Shank-Mods/LumaDoub/hardware/LumaDoubDevBoard/LumaDoubDevBoard.kicad_pcb

## KiCad design hardware/LumaDoubDevBoard/LumaDoubDevBoard.kicad_pcb (2026-09-02)

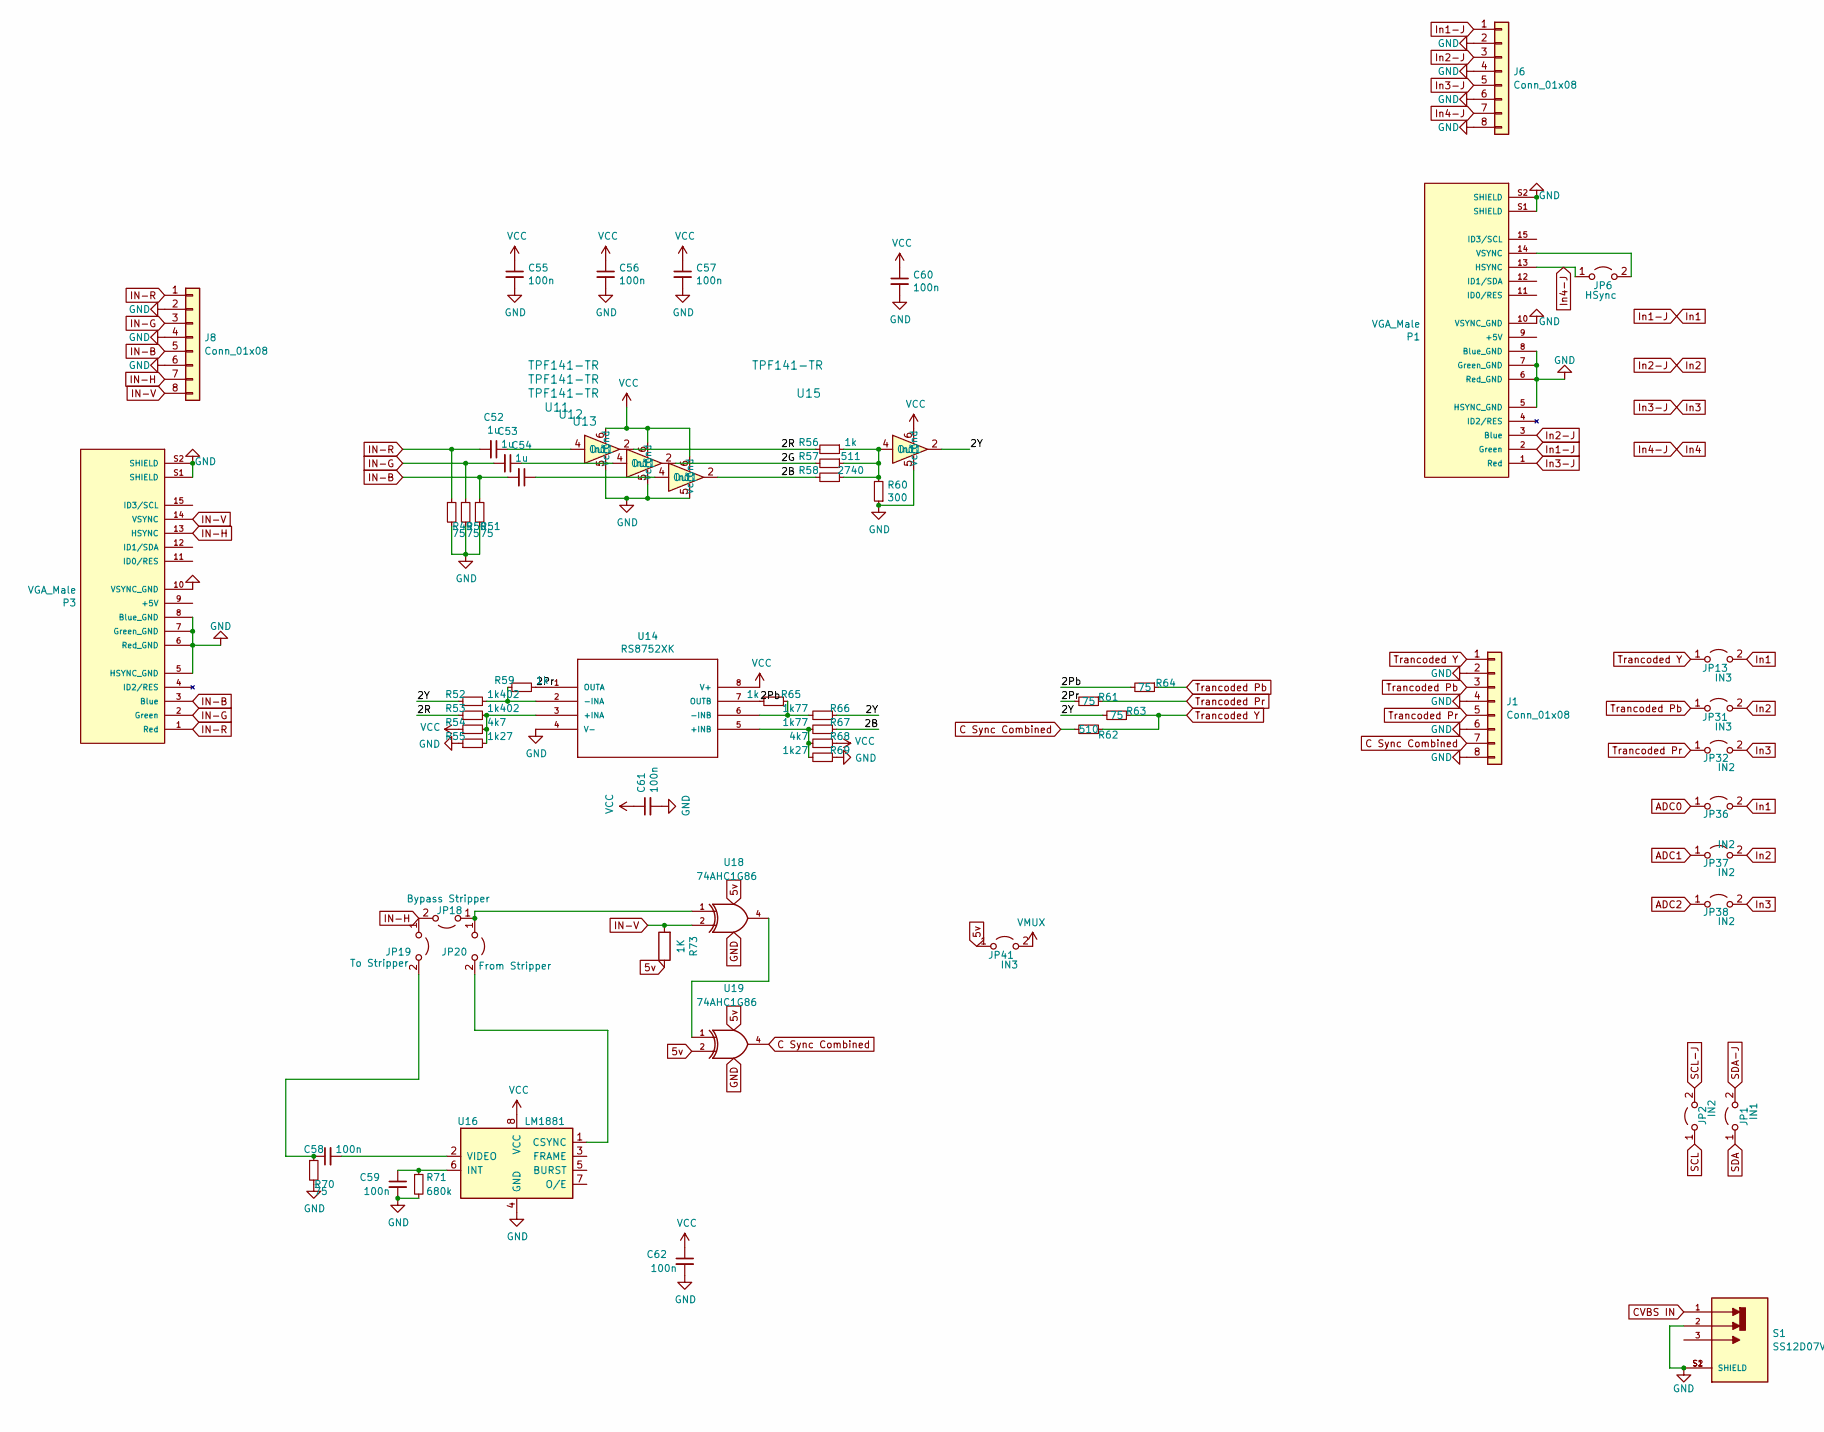
[picture p1: schematic LumaDoubDevBoard.kicad_sch, part in row 1, column 1]

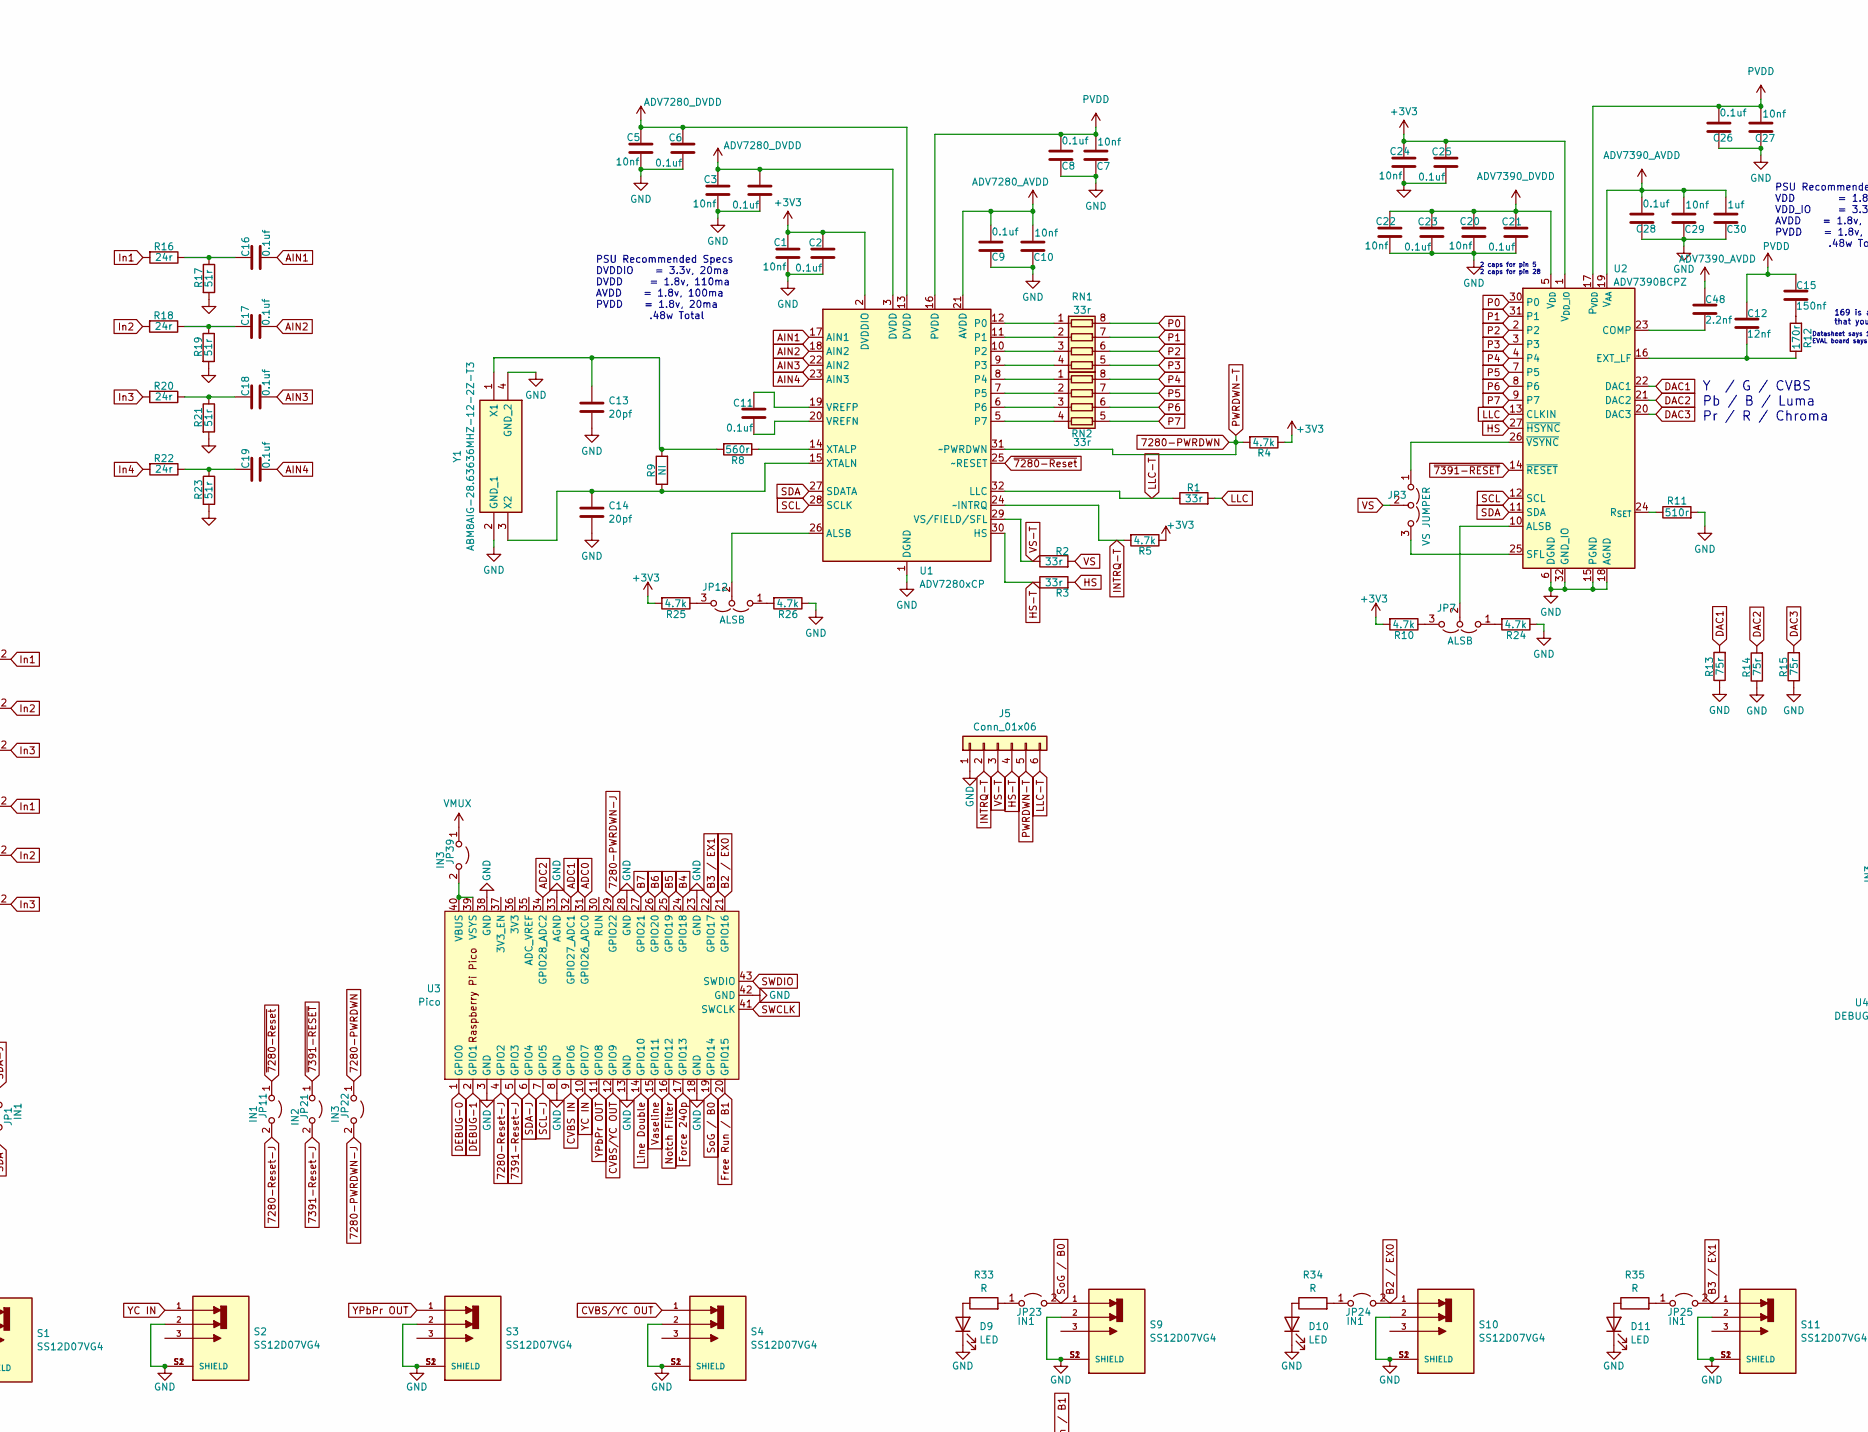
[picture p2: schematic LumaDoubDevBoard.kicad_sch, part in row 1, column 2]

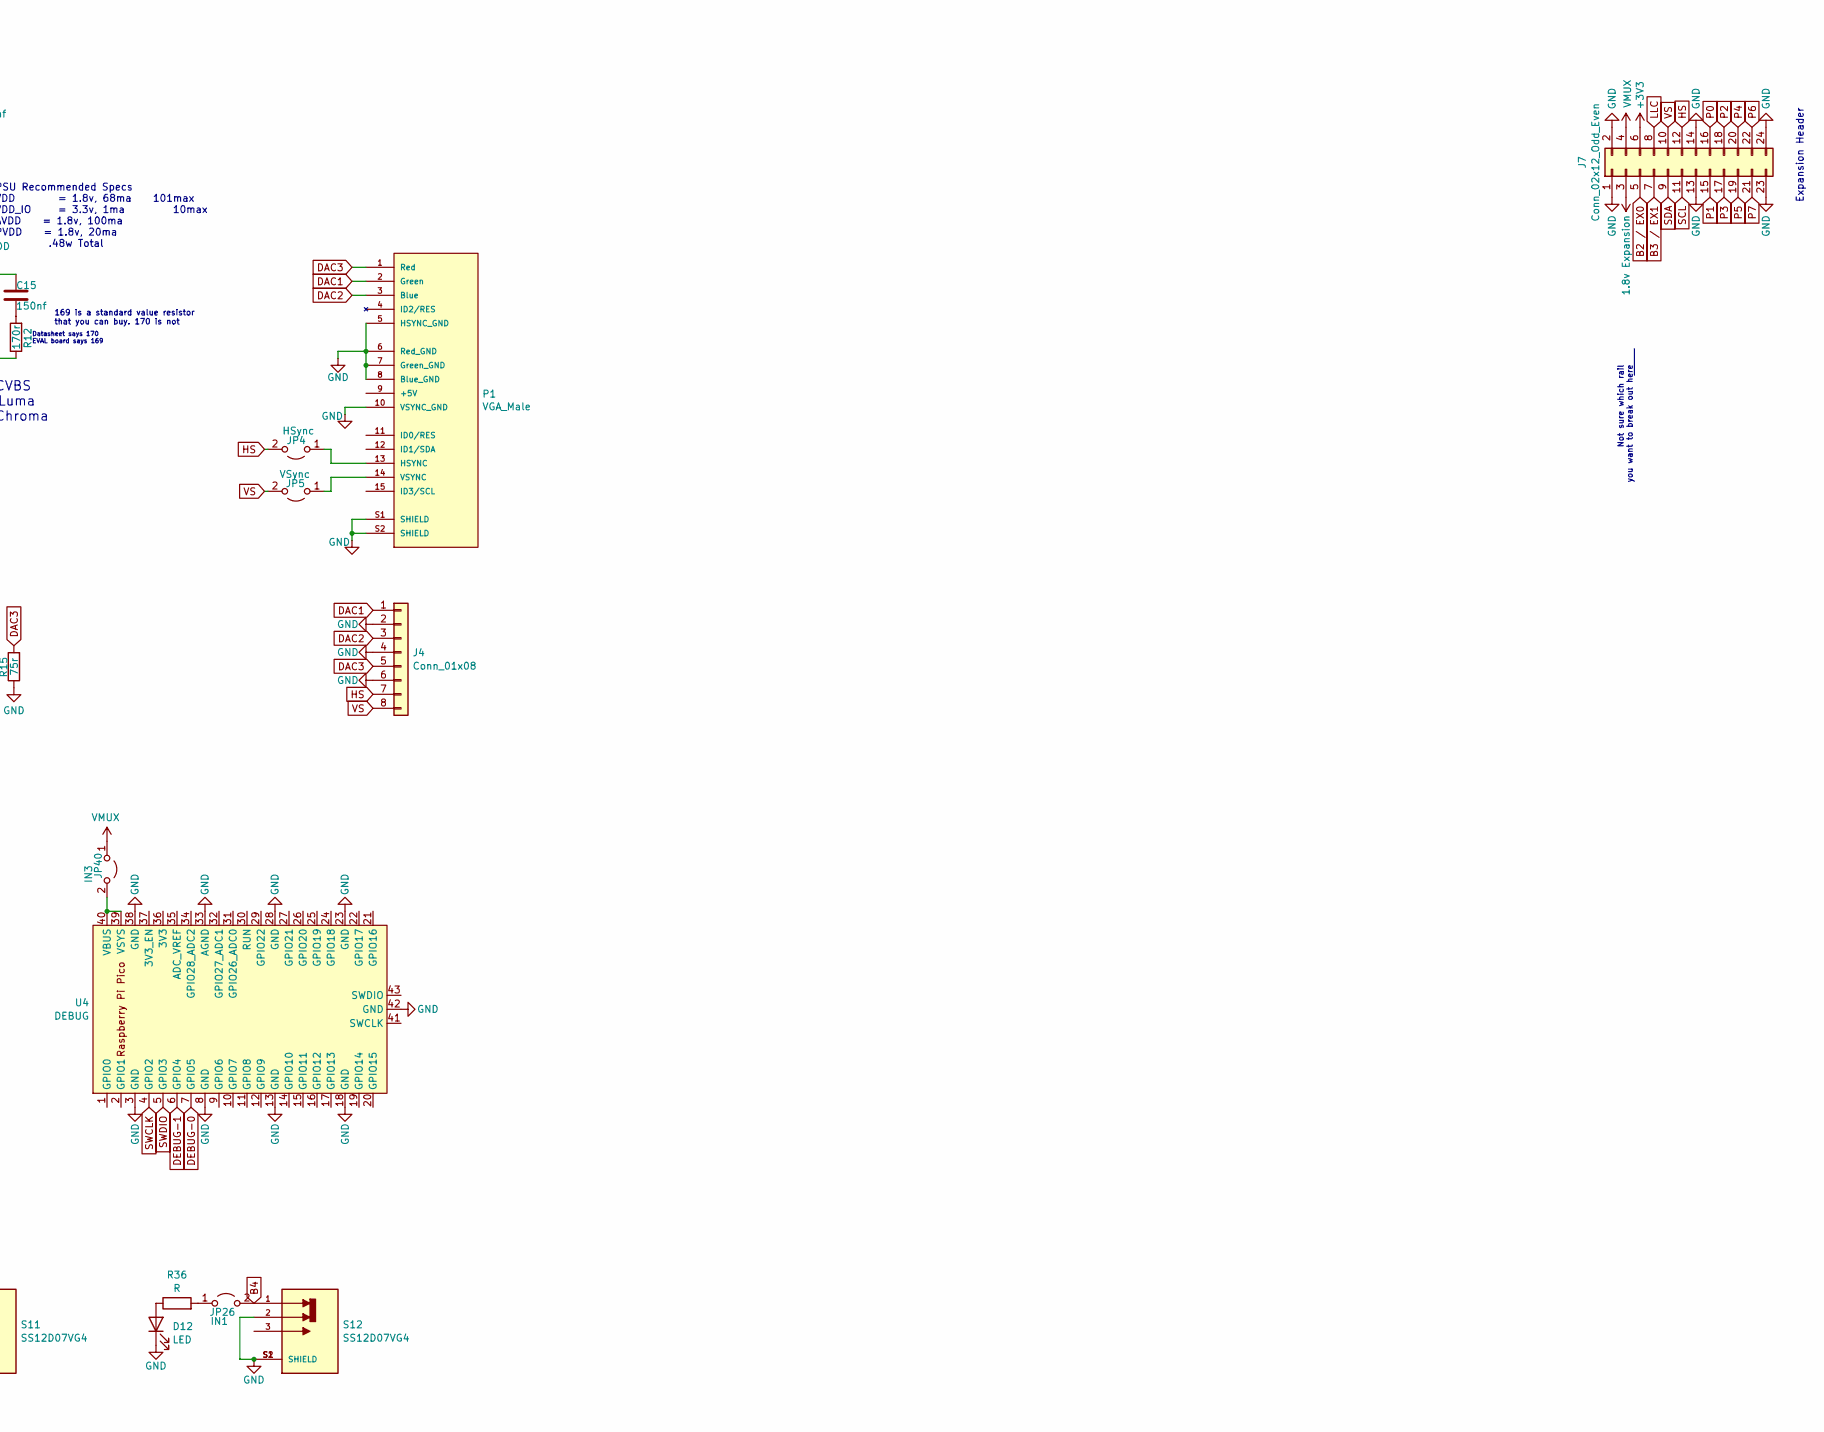
[picture p3: schematic LumaDoubDevBoard.kicad_sch, part in row 1, column 3]

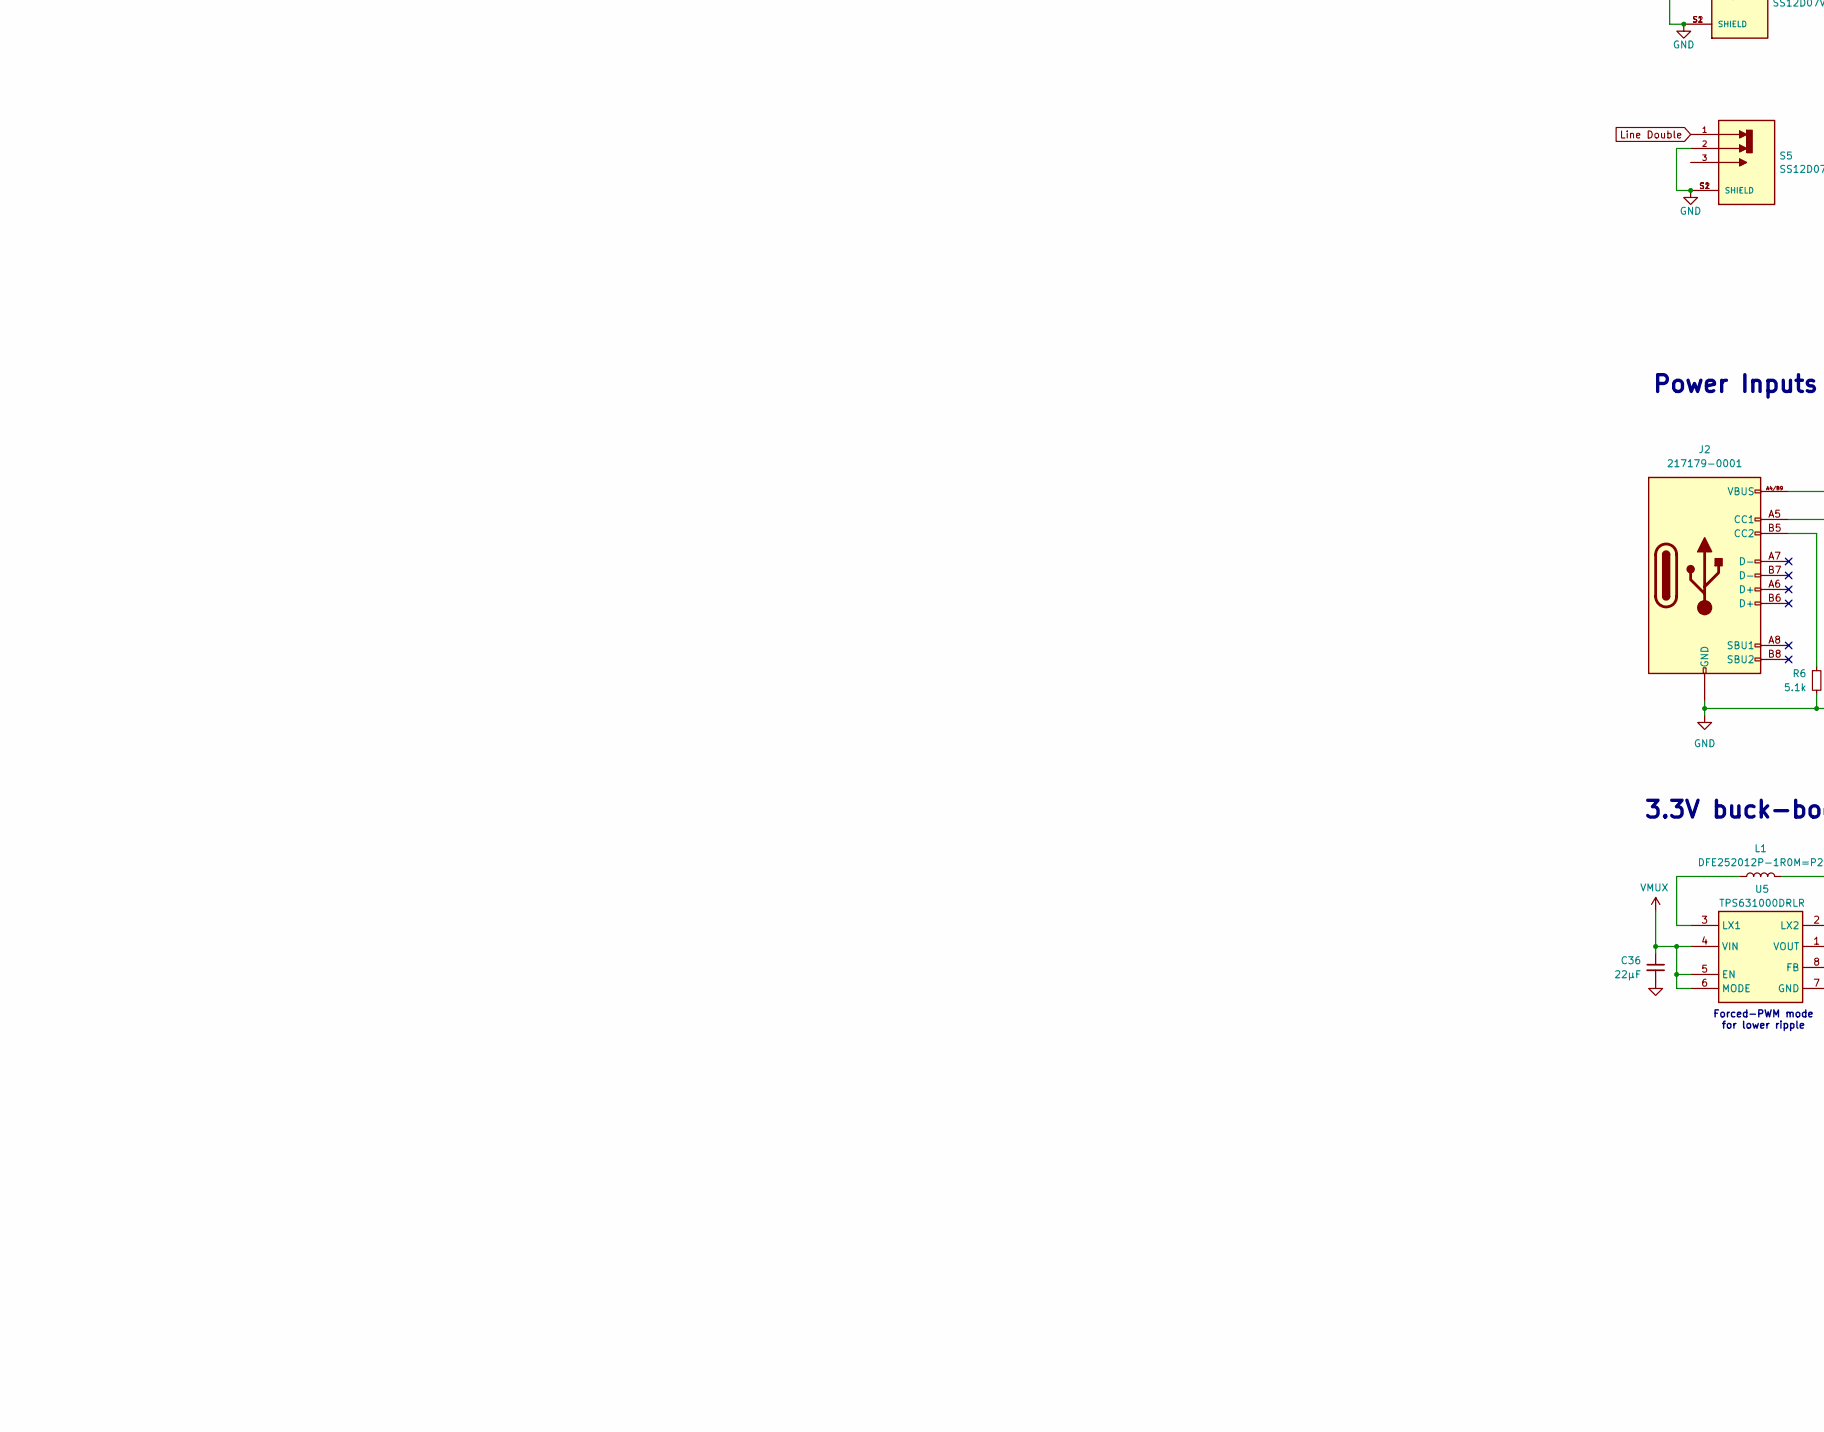
[picture p4: schematic LumaDoubDevBoard.kicad_sch, part in row 2, column 1]

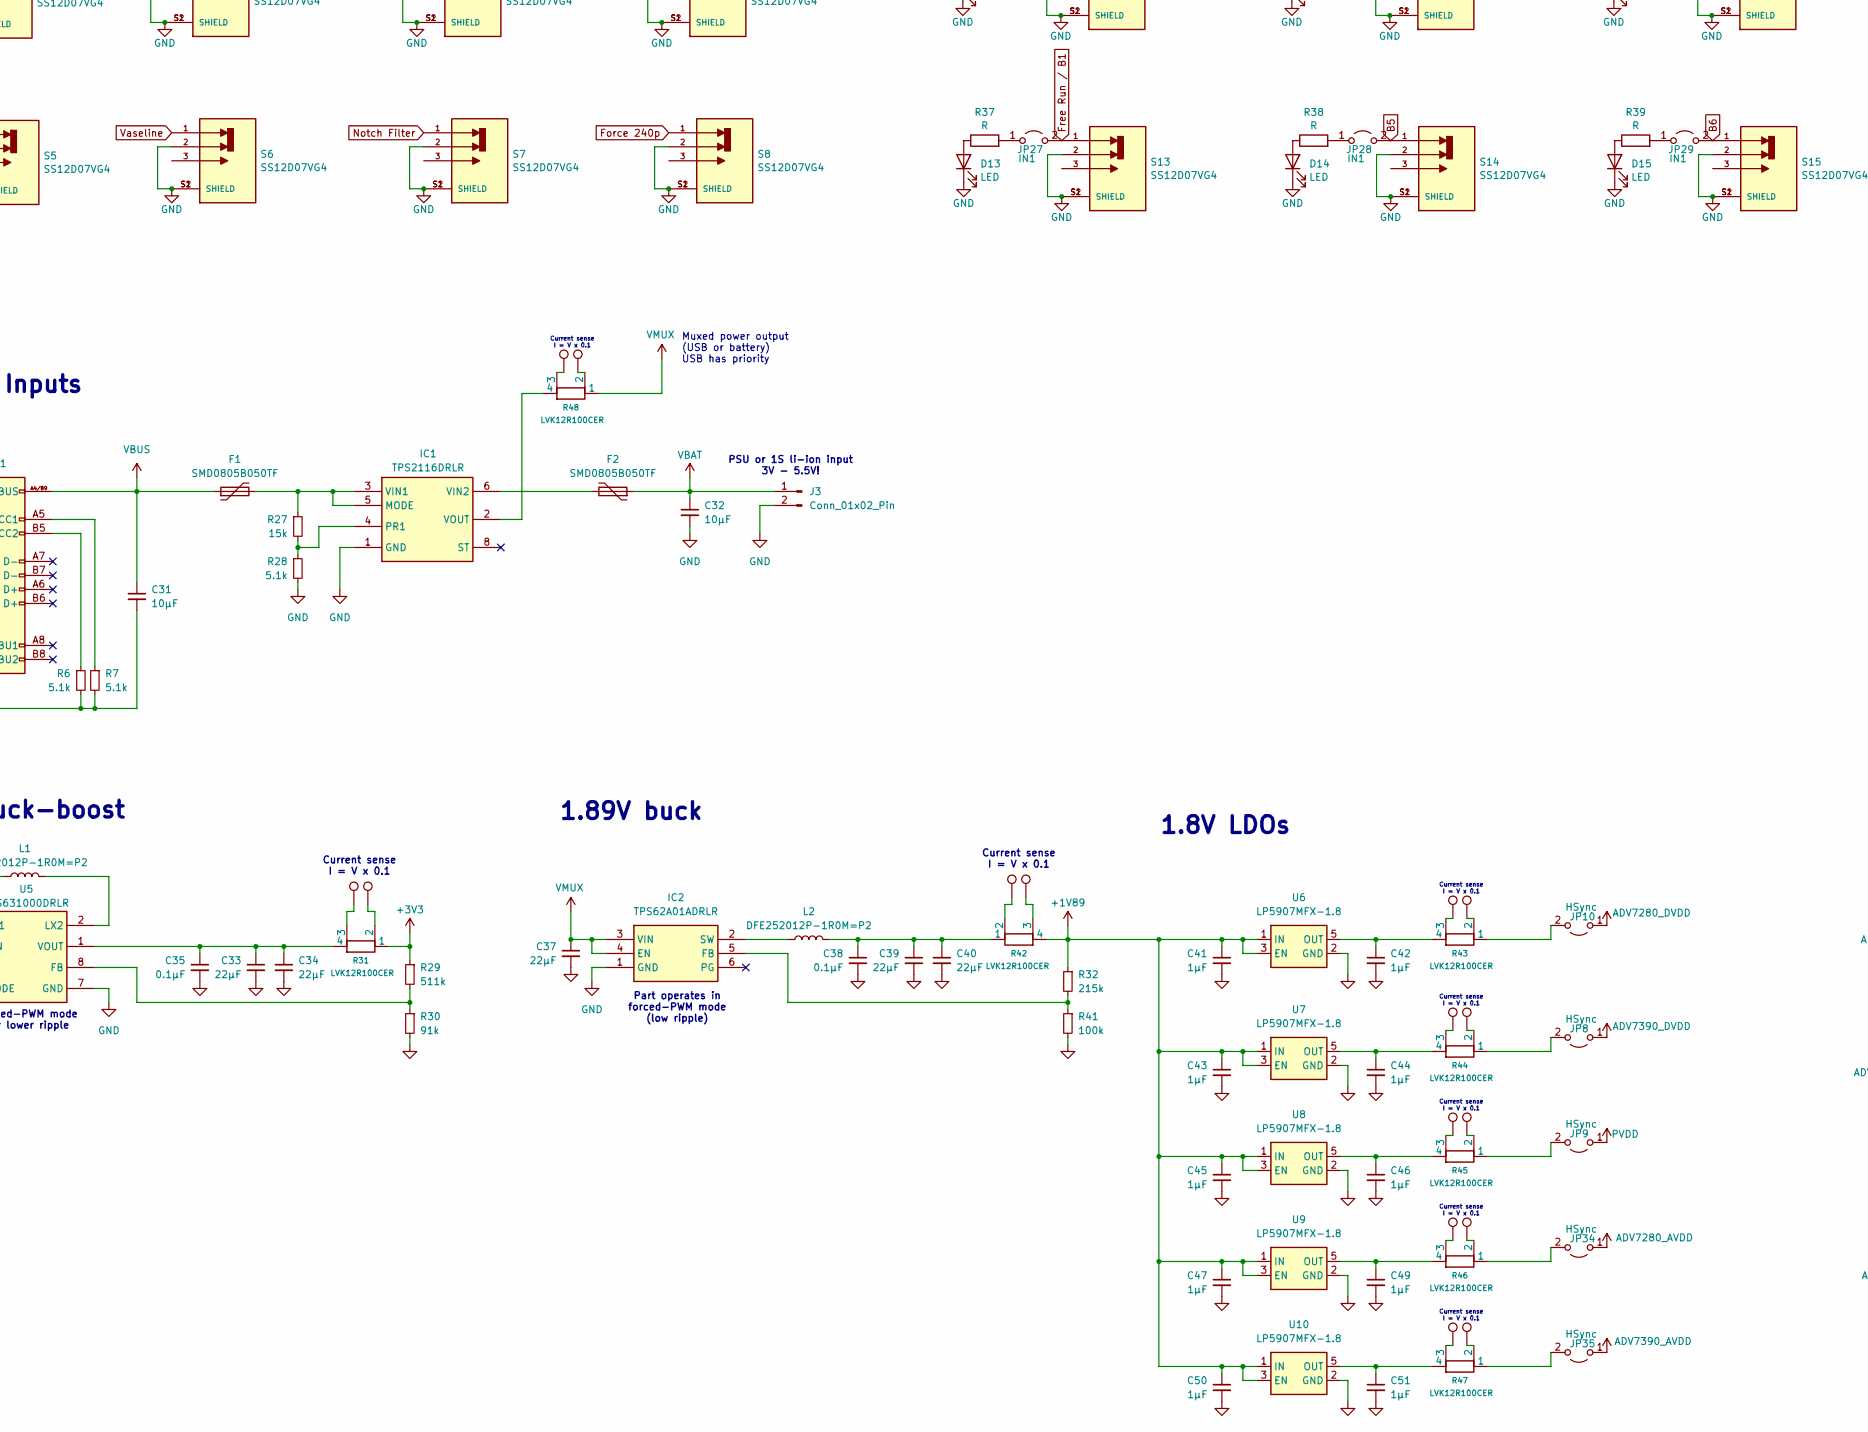
[picture p5: schematic LumaDoubDevBoard.kicad_sch, part in row 2, column 2]

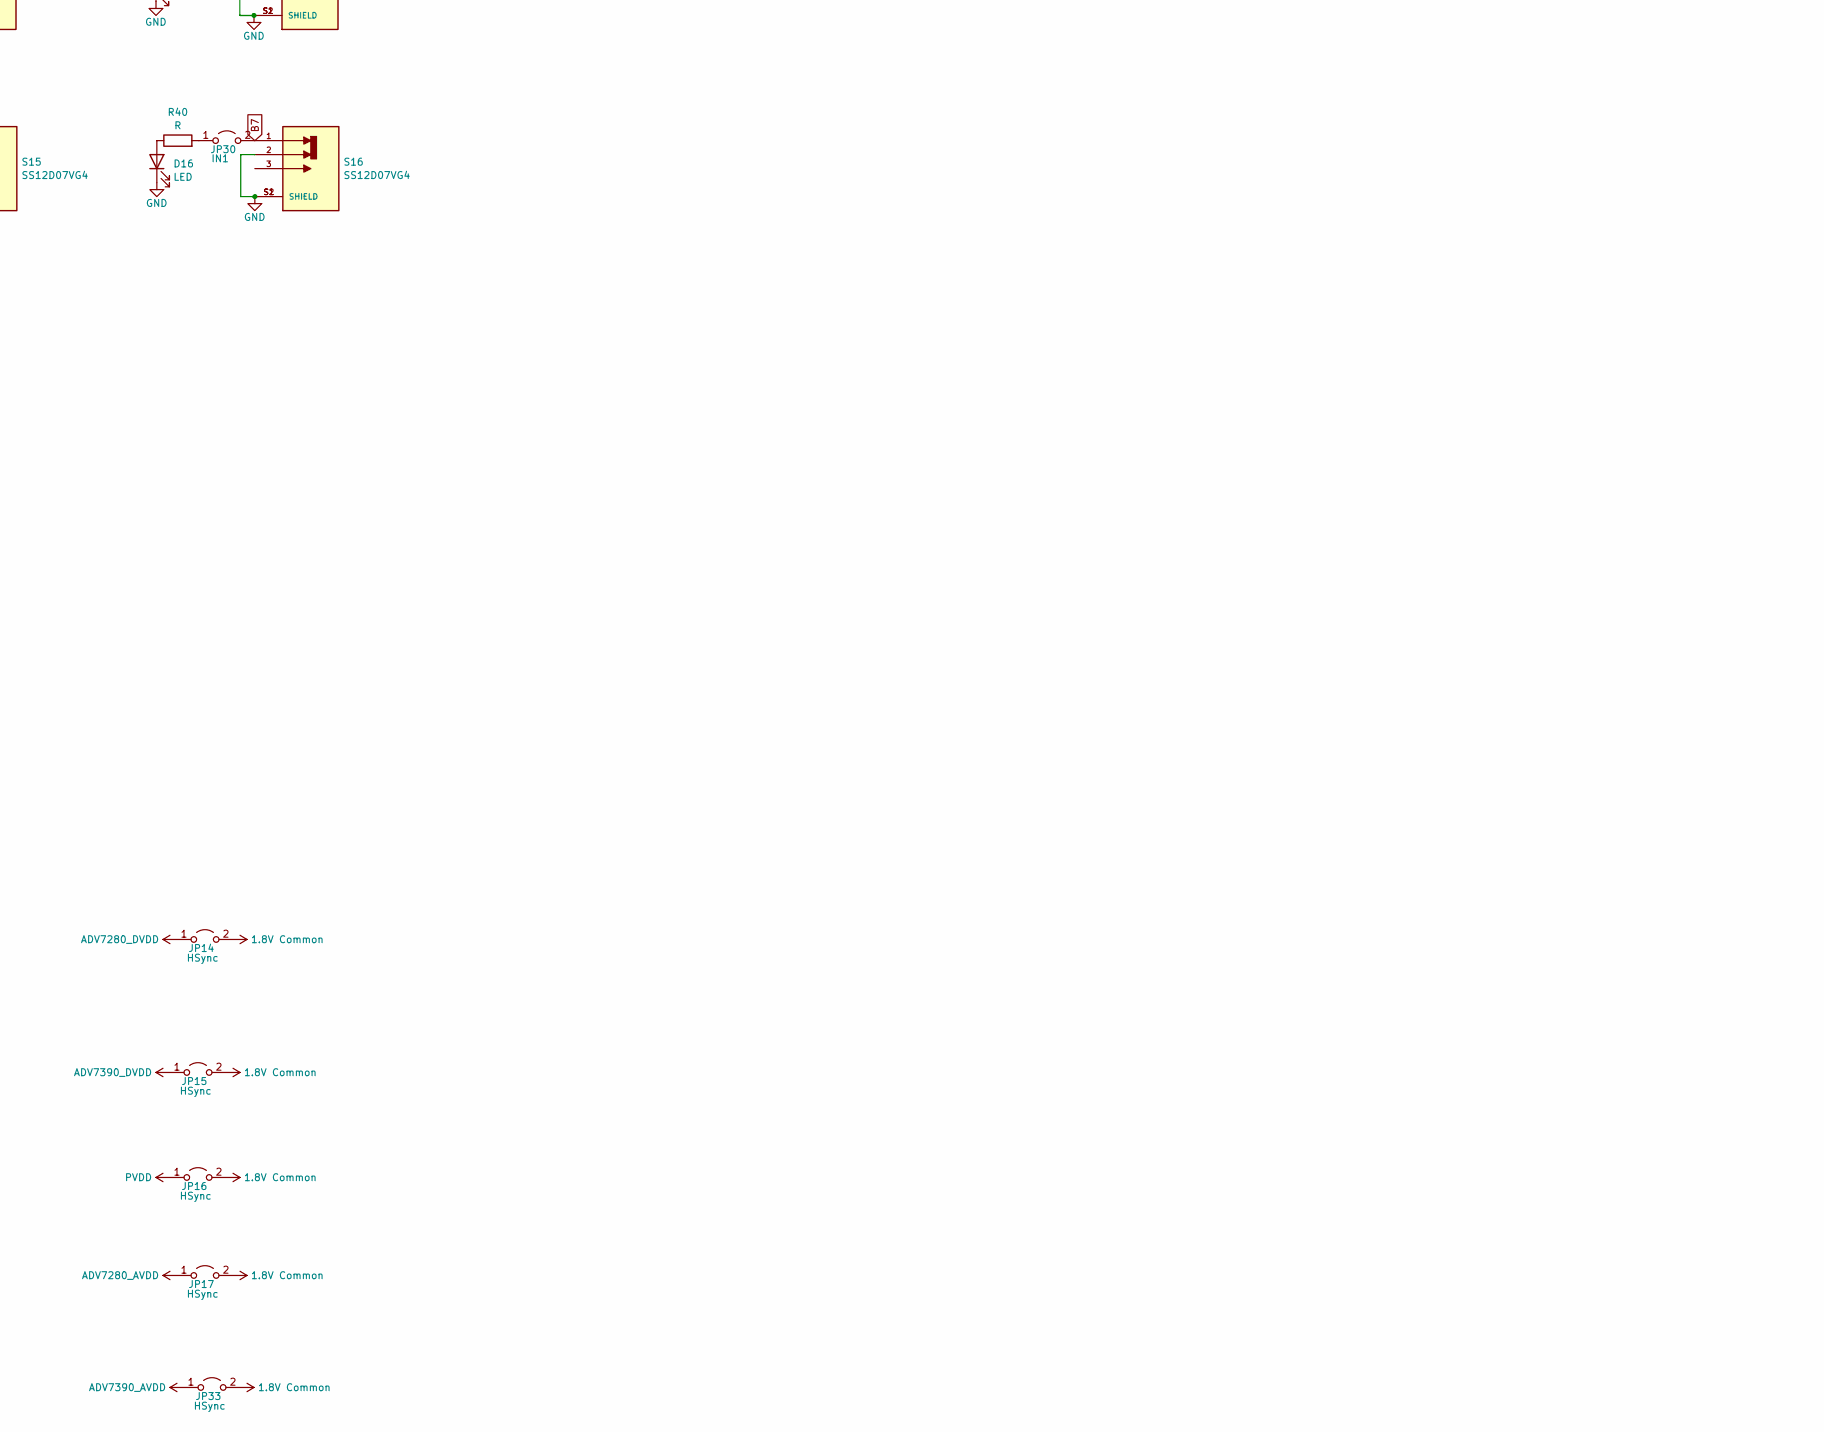
[picture p6: schematic LumaDoubDevBoard.kicad_sch, part in row 2, column 3]

Parts:
C1, C3, C5, C7, C10, C20, C22, C24, C27, C29: 10nf; Cap_SMD_0603
C2, C4, C6, C8, C9, C11, C16, C17, C18, C19, C21, C23, C25, C26, C28: 0.1uf; Cap_SMD_0603
C12: 12nf; Cap_SMD_0603
C13, C14: 20pf; Cap_SMD_0603
C15: 150nf; Cap_SMD_0603
C30: 1uf; Cap_SMD_0603
C31, C32: 10μF; C_0603_1608Metric
C33, C34, C36, C37, C39, C40: 22μF; C_0603_1608Metric
C35, C38: 0.1μF; C_0402_1005Metric
C41, C42, C43, C44, C45, C46, C47, C49, C50, C51: 1μF; C_0402_1005Metric
C48: 2.2nf; Cap_SMD_0603
C52, C53, C54: 1u; Cap_SMD_0603; LCSC C28323
C55, C56, C57, C58, C59, C60, C61, C62: 100n; Cap_SMD_0603; LCSC C14663
D9, D10, D11, D12, D13, D14, D15, D16: LED; LED_D5.0mm
F1, F2: SMD0805B050TF; Fuse_0805_2012Metric
IC1: TPS2116DRLR; SOTFL50P160X60-8N; Mouser Part Number 595-TPS2116DRLR
IC2: TPS62A01ADRLR; SOTFL50P160X60-6N; Mouser Part Number 595-TPS62A01ADRLR
J1, J4, J6, J8: Conn_01x08; PinHeader_1x08_P2.54mm_Vertical
J2: 217179-0001; 2171790001
J3: Conn_01x02_Pin; PinHeader_1x02_P2.54mm_Vertical
J5: Conn_01x06; PinHeader_1x06_P2.54mm_Vertical
J7: Conn_02x12_Odd_Even; PinHeader_2x12_P2.54mm_Vertical
JP1, JP11, JP23, JP24, JP25, JP26, JP27, JP28, JP29, JP30: IN1; SolderJumper-2_P1.3mm_Open_TrianglePad1.0x1.5mm
JP2, JP21, JP32, JP36, JP37, JP38: IN2; SolderJumper-2_P1.3mm_Open_TrianglePad1.0x1.5mm
JP3: VS JUMPER; SolderJumper-3_P2.0mm_Open_TrianglePad1.0x1.5mm
JP4, JP6, JP8, JP9, JP10, JP14, JP15, JP16, JP17, JP33, JP34, JP35: HSync; SolderJumper-2_P1.3mm_Open_TrianglePad1.0x1.5mm
JP5: VSync; SolderJumper-2_P1.3mm_Open_TrianglePad1.0x1.5mm
JP7, JP12: ALSB; SolderJumper-3_P2.0mm_Open_TrianglePad1.0x1.5mm
JP13, JP22, JP31, JP39, JP40, JP41: IN3; SolderJumper-2_P1.3mm_Open_TrianglePad1.0x1.5mm
JP18: Bypass Stripper; SolderJumper-2_P1.3mm_Open_TrianglePad1.0x1.5mm
JP19: To Stripper; SolderJumper-2_P1.3mm_Open_TrianglePad1.0x1.5mm
JP20: From Stripper; SolderJumper-2_P1.3mm_Open_TrianglePad1.0x1.5mm
L1, L2: DFE252012P-1R0M=P2; L_1008_2520Metric
P1, P3: VGA_Male; VGA_male_rightangle_slim; PARTREV N/A
R1, R2, R3: 33r; R_0603_1608Metric
R4, R5, R10, R24, R25, R26: 4.7k; R_0603_1608Metric
R6, R7, R28: 5.1k; R_0603_1608Metric
R8: 560r; R_0603_1608Metric
R9: NI; R_0603_1608Metric
R11: 510r; R_0603_1608Metric
R12: 170r; R_0603_1608Metric
R13, R14, R15: 75r; R_0603_1608Metric
R16, R18, R20, R22: 24r; R_0603_1608Metric
R17, R19, R21, R23: 51r; R_0603_1608Metric
R27: 15k; R_0603_1608Metric
R29: 511k; R_0603_1608Metric
R30: 91k; R_0603_1608Metric
R31, R42, R43, R44, R45, R46, R47, R48: LVK12R100CER; R_Shunt_Ohmite_LVK12
R32: 215k; R_0603_1608Metric
R33, R34, R35, R36, R37, R38, R39, R40: R; R_0603_1608Metric
R41: 100k; R_0603_1608Metric
R49, R50, R51, R61, R63, R64, R70: 75; R_0603_1608Metric; LCSC C20638
R52, R53: 1k402; R_0603_1608Metric; LCSC C17388
R54, R68: 4k7; R_0603_1608Metric; LCSC C17673
R55, R69: 1k27; R_0603_1608Metric; LCSC C40880
R56, R59, R65: 1k; R_0603_1608Metric; LCSC C17513
R57: 511; R_0603_1608Metric; LCSC C273884
R58: 2740; R_0603_1608Metric; LCSC C26009
R60: 300; R_0603_1608Metric; LCSC C17617
R62: 510; R_0603_1608Metric; LCSC C17734
R66, R67: 1k77; R_0603_1608Metric; LCSC C17397
R71: 680k; R_0603_1608Metric; LCSC C17797
R73: 1K; R_0603_1608Metric
RN1, RN2: 33r; R_Array_Convex_4x1206
S1, S2, S3, S4, S5, S6, S7, S8, S9, S10, S11, S12, S13, S14, S15, S16: SS12D07VG4; SW_SS12D07VG4; PARTREV 1
TP13, TP14, TP15, TP16, TP17, TP18, TP19, TP20, TP21, TP22, TP23, TP24, TP25, TP26, TP27, TP28: TestPoint; TestPoint_THTPad_D1.5mm_Drill0.7mm
U1: ADV7280xCP; LFCSP-32-1EP_5x5mm_P0.5mm_EP3.6x3.6mm
U2: ADV7390BCPZ; LFCSP-32-1EP_5x5mm_P0.5mm_EP3.1x3.1mm
U3: Pico; RPi_Pico_SMD_TH
U4: DEBUG; RPi_Pico_SMD_TH
U5: TPS631000DRLR; SOTFL50P160X60-8N; Mouser Part Number 595-TPS631000DRLR
U6, U7, U8, U9, U10: LP5907MFX-1.8; SOT-23-5
U11, U12, U13, U15: TPF141-TR; SOT-23-6_Handsoldering; LCSC C155440
U14: RS8752XK; SOIC-8_3.9x4.9mm_P1.27mm; LCSC C236994
U16: LM1881; SOIC-8_3.9x4.9mm_P1.27mm; LCSC C518922
U18, U19: 74AHC1G86; SOT-23-5
Y1: ABM8AIG-28.63636MHZ-12-2Z-T3; ABM8AIG25000MHZ122ZT3; Mouser Part Number 815-MAIG28.6-12-2ZT3

Connections:
1.8V Common: JP14.2 (B), JP15.2 (B), JP16.2 (B), JP17.2 (B), JP33.2 (B)
1.8v Expansion: J7.3
7280-PWRDWN: J5.5, JP22.1 (A), R4.2, U1.31 (~PWRDWN)
7280-PWRDWN-J: JP22.2 (B), U3.29 (GPIO22)
7280-Reset-J: JP11.2 (B), U3.4 (GPIO2)
7391-Reset-J: JP21.2 (B), U3.5 (GPIO3)
+1V89: C41.1, C43.1, C45.1, C47.1, C50.1, R32.1, R42.4, U6.1 (IN), U6.3 (EN), U7.1 (IN), U7.3 (EN), U8.1 (IN), U8.3 (EN), U9.1 (IN), U9.3 (EN), U10.1 (IN), U10.3 (EN)
+3V3: C1.1, C2.1, C24.1, C25.1, J7.6, R4.1, R5.1, R10.2, R25.2, R29.1, R31.1, U1.2 (DVDDIO), U2.1 (V_{DD_IO})
/2B: R58.2, R67.1, U13.2 (Out1)
/2G: R57.2, U12.2 (Out1)
/2Pb: R64.2, R65.2, U14.7 (OUTB)
/2Pr: R59.2, R61.2, U14.1 (OUTA)
/2R: R53.1, R56.2, U11.2 (Out1)
/2Y: R52.1, R63.2, R66.1, U15.2 (Out1)
ADC0: JP36.1 (A), U3.31 (GPIO26_ADC0)
ADC1: JP37.1 (A), U3.32 (GPIO27_ADC1)
ADC2: JP38.1 (A), U3.34 (GPIO28_ADC2)
ADV7280_AVDD: C9.2, C10.2, JP17.1 (A), JP34.1 (A), U1.21 (AVDD)
ADV7280_DVDD: C3.1, C4.1, C5.1, C6.1, JP10.1 (A), JP14.1 (A), U1.3 (DVDD), U1.13 (DVDD)
ADV7390_AVDD: C28.2, C29.2, C30.2, C48.1, JP33.1 (A), JP35.1 (A), U2.19 (V_{AA})
ADV7390_DVDD: C20.1, C21.1, C22.1, C23.1, JP8.1 (A), JP15.1 (A), U2.5 (V_{DD}), U2.28 (V_{DD})
AIN1: C16.2, U1.17 (AIN1)
AIN2: C17.2, U1.18 (AIN2)
AIN3: C18.2, U1.22 (AIN2)
AIN4: C19.2, U1.23 (AIN3)
B2 / EX0: J7.5, JP24.2 (B), S10.1, U3.21 (GPIO16)
B3 / EX1: J7.7, JP25.2 (B), S11.1, U3.22 (GPIO17)
B4: JP26.2 (B), S12.1, U3.24 (GPIO18)
B5: JP28.2 (B), S14.1, U3.25 (GPIO19)
B6: JP29.2 (B), S15.1, U3.26 (GPIO20)
B7: JP30.2 (B), S16.1, U3.27 (GPIO21)
C Sync Combined: J1.7, R62.2, U19.4
CVBS IN: S1.1, U3.9 (GPIO6)
CVBS/YC OUT: S4.1, U3.12 (GPIO9)
DEBUG-0: U3.1 (GPIO0), U4.7 (GPIO5)
DEBUG-1: U3.2 (GPIO1), U4.6 (GPIO4)
Force 240p: S8.1, U3.17 (GPIO13)
Free Run / B1: JP27.2 (B), S13.1, U3.20 (GPIO15)
GND: C1.2, C2.2, C3.2, C4.2, C5.2, C6.2, C7.1, C8.1, C9.1, C10.1, C13.1, C14.1, C20.2, C21.2, C22.2, C23.2, C24.2, C25.2, C26.1, C27.1, C28.1, C29.1, C30.1, C31.2, C32.2, C33.2, C34.2, C35.2, C36.2, C37.2, C38.2, C39.2, C40.2, C41.2, C42.2, C43.2, C44.2, C45.2, C46.2, C47.2, C49.2, C50.2, C51.2, C55.2, C56.2, C57.2, C59.2, C60.2, C61.2, C62.2, D9.1 (K), D10.1 (K), D11.1 (K), D12.1 (K), D13.1 (K), D14.1 (K), D15.1 (K), D16.1 (K), IC1.1 (GND), IC2.1 (GND), J1.2, J1.4, J1.6, J1.8, J2.1 (GND), J2.2 (GND), J2.3 (GND), J2.4 (GND), J2.13 (GND), J2.14 (GND), J2.15 (GND), J2.16 (GND), J2.A1/B12 (GND_2), J2.B1/A12 (GND), J2.S_1_H1 (GND), J2.S_1_H2 (GND), J2.S_2_H1 (GND), J2.S_2_H2 (GND), J2.S_3_H1 (GND), J2.S_3_H2 (GND), J2.S_4_H1 (GND), J2.S_4_H2 (GND), J3.2, J4.2, J4.4, J4.6, J5.1, J6.2, J6.4, J6.6, J6.8, J7.1, J7.2, J7.13, J7.14, J7.23, J7.24, J8.2, J8.4, J8.6, P1.5 (HSYNC_GND), P1.6 (Red_GND), P1.7 (Green_GND), P1.8 (Blue_GND), P1.10 (VSYNC_GND), P1.S1 (SHIELD), P1.S2 (SHIELD), P3.5 (HSYNC_GND), P3.6 (Red_GND), P3.7 (Green_GND), P3.8 (Blue_GND), P3.10 (VSYNC_GND), P3.S1 (SHIELD), P3.S2 (SHIELD), R6.2, R7.2, R11.2, R13.1, R14.1, R15.1, R17.2, R19.2, R21.2, R23.2, R24.1, R26.1, R28.2, R30.2, R41.2, R49.2, R50.2, R51.2, R55.1, R60.1, R69.1, R70.2, R71.2, S1.2, S1.S1 (SHIELD), S1.S2 (SHIELD), S2.2, S2.S1 (SHIELD), S2.S2 (SHIELD), S3.2, S3.S1 (SHIELD), S3.S2 (SHIELD), S4.2, S4.S1 (SHIELD), S4.S2 (SHIELD), S5.2, S5.S1 (SHIELD), S5.S2 (SHIELD), S6.2, S6.S1 (SHIELD), S6.S2 (SHIELD), S7.2, S7.S1 (SHIELD), S7.S2 (SHIELD), S8.2, S8.S1 (SHIELD), S8.S2 (SHIELD), S9.2, S9.S1 (SHIELD), S9.S2 (SHIELD), S10.2, S10.S1 (SHIELD), S10.S2 (SHIELD), S11.2, S11.S1 (SHIELD), S11.S2 (SHIELD), S12.2, S12.S1 (SHIELD), S12.S2 (SHIELD), S13.2, S13.S1 (SHIELD), S13.S2 (SHIELD), S14.2, S14.S1 (SHIELD), S14.S2 (SHIELD), S15.2, S15.S1 (SHIELD), S15.S2 (SHIELD), S16.2, S16.S1 (SHIELD), S16.S2 (SHIELD), U1.1 (DGND), U1.4 (DGND), U1.33 (DGND), U2.6 (DGND), U2.15 (PGND), U2.18 (AGND), U2.29 (DGND), U2.32 (GND_IO), U2.33 (AGND), U3.3 (GND), U3.8 (GND), U3.13 (GND), U3.18 (GND), U3.23 (GND), U3.28 (GND), U3.33 (AGND), U3.38 (GND), U3.42 (GND), U4.3 (GND), U4.8 (GND), U4.13 (GND), U4.18 (GND), U4.23 (GND), U4.28 (GND), U4.33 (AGND), U4.38 (GND), U4.42 (GND), U5.7 (GND), U6.2 (GND), U7.2 (GND), U8.2 (GND), U9.2 (GND), U10.2 (GND), U11.5 (Gnd), U12.5 (Gnd), U13.5 (Gnd), U14.4 (V-), U15.5 (Gnd), U16.4 (GND), U18.3 (GND), U19.3 (GND), Y1.2 (GND_1), Y1.4 (GND_2); also elsewhere on the board
HS: J4.7, J7.12, JP4.2 (B), R3.2, U2.27 (~HSYNC)
HS-T: J5.4, R3.1, U1.30 (HS)
IN-B: C54.2, J8.5, P3.3 (Blue), R51.1
IN-G: C53.2, J8.3, P3.2 (Green), R50.1
IN-H: J8.7, JP18.2 (B), JP19.1 (A), P3.13 (HSYNC)
IN-R: C52.2, J8.1, P3.1 (Red), R49.1
IN-V: J8.8, P3.14 (VSYNC), R73.2, U18.2
INTRQ-T: J5.2, R5.2, U1.24 (~INTRQ)
LLC: J7.8, R1.2, U2.13 (CLKIN)
LLC-T: J5.6, R1.1, U1.32 (LLC)
Line Double: S5.1, U3.14 (GPIO10)
unnamed: C15.2, R12.2
unnamed: C16.1, R16.1, R17.1
unnamed: C17.1, R18.1, R19.1
unnamed: C18.1, R20.1, R21.1
unnamed: C19.1, R22.1, R23.1
unnamed: C38.1, C39.1, C40.1, L2.2, R42.1
unnamed: D9.2 (A), R33.1
unnamed: D10.2 (A), R34.1
unnamed: D11.2 (A), R35.1
unnamed: D12.2 (A), R36.1
unnamed: D13.2 (A), R37.1
unnamed: D14.2 (A), R38.1
unnamed: D15.2 (A), R39.1
unnamed: D16.2 (A), R40.1
unnamed: F1.2, IC1.3 (VIN1), IC1.5 (MODE), R27.1
unnamed: IC1.4 (PR1), R27.2, R28.1
unnamed: F2.2, IC1.6 (VIN2)
unnamed: IC1.2 (VOUT), IC1.7 (VOUT_2), R48.4
unnamed: IC2.5 (FB), R32.2, R41.1
unnamed: IC2.2 (SW), L2.1
unnamed: J2.A5 (CC1), R7.1
unnamed: J2.B5 (CC2), R6.1
unnamed: JP3.1 (A), U2.26 (~VSYNC)
unnamed: JP3.3 (B), U2.25 (SFL)
unnamed: JP7.1 (A), R24.2
unnamed: JP7.3 (B), R10.1
unnamed: JP7.2 (C), U2.10 (ALSB)
unnamed: JP8.2 (B), R44.1
unnamed: JP9.2 (B), R45.1
unnamed: JP10.2 (B), R43.1
unnamed: JP12.1 (A), R26.2
unnamed: JP12.3 (B), R25.1
unnamed: JP12.2 (C), U1.26 (ALSB)
unnamed: JP18.1 (A), JP20.1 (A), U18.1
unnamed: C58.1, JP19.2 (B), R70.1
unnamed: JP20.2 (B), U16.1 (CSYNC)
unnamed: JP23.1 (A), R33.2
unnamed: JP24.1 (A), R34.2
unnamed: JP25.1 (A), R35.2
unnamed: JP26.1 (A), R36.2
unnamed: JP27.1 (A), R37.2
unnamed: JP28.1 (A), R38.2
unnamed: JP29.1 (A), R39.2
unnamed: JP30.1 (A), R40.2
unnamed: JP34.2 (B), R46.1
unnamed: JP35.2 (B), R47.1
unnamed: JP39.2 (B), U3.39 (VSYS), U3.40 (VBUS)
unnamed: JP40.2 (B), U4.39 (VSYS), U4.40 (VBUS)
unnamed: R31.2, TP14.1
unnamed: R31.3, TP13.1
unnamed: R42.2, TP15.1
unnamed: R42.3, TP16.1
unnamed: R43.2, TP18.1
unnamed: R43.3, TP17.1
unnamed: R44.2, TP20.1
unnamed: R44.3, TP19.1
unnamed: R45.2, TP22.1
unnamed: R45.3, TP21.1
unnamed: R46.2, TP24.1
unnamed: R46.3, TP23.1
unnamed: R47.2, TP26.1
unnamed: R47.3, TP25.1
unnamed: R48.2, TP28.1
unnamed: R48.3, TP27.1
unnamed: RN1.1 (R1.1), U1.12 (P0)
unnamed: RN1.2 (R2.1), U1.11 (P1)
unnamed: RN1.3 (R3.1), U1.10 (P2)
unnamed: RN1.4 (R4.1), U1.9 (P3)
unnamed: RN2.1 (R1.1), U1.8 (P4)
unnamed: RN2.2 (R2.1), U1.7 (P5)
unnamed: RN2.3 (R3.1), U1.6
unnamed: RN2.4 (R4.1), U1.5 (P7)
unnamed: C11.2, U1.20 (VREFN)
unnamed: C11.1, U1.19 (VREFP)
unnamed: C14.2, R9.1, U1.15 (XTALN), Y1.3 (X2)
unnamed: R8.1, U1.14 (XTALP)
unnamed: C48.2, U2.23 (COMP)
unnamed: C12.2, R12.1, U2.16 (EXT_LF)
unnamed: R11.1, U2.24 (R_{SET})
unnamed: R29.2, R30.1, U5.8 (FB)
unnamed: L1.1, U5.3 (LX1)
unnamed: L1.2, U5.2 (LX2)
unnamed: C33.1, C34.1, C35.1, R31.4, U5.1 (VOUT)
unnamed: C42.1, R43.4, U6.5 (OUT)
unnamed: C44.1, R44.4, U7.5 (OUT)
unnamed: C46.1, R45.4, U8.5 (OUT)
unnamed: C49.1, R46.4, U9.5 (OUT)
unnamed: C51.1, R47.4, U10.5 (OUT)
unnamed: C52.1, U11.4 (In1)
unnamed: C53.1, U12.4 (In1)
unnamed: C54.1, U13.4 (In1)
unnamed: R53.2, R54.2, R55.2, U14.3 (+INA)
unnamed: R67.2, R68.2, R69.2, U14.5 (+INB)
unnamed: R52.2, R59.1, U14.2 (-INA)
unnamed: R65.1, R66.2, U14.6 (-INB)
unnamed: R56.1, R57.1, R58.1, R60.2, U15.4 (In1)
unnamed: C59.1, R71.1, U16.6 (INT)
unnamed: C58.2, U16.2 (VIDEO)
unnamed: U18.4, U19.1
unnamed: C13.2, R8.2, R9.2, Y1.1 (X1)
Notch Filter: S7.1, U3.16 (GPIO12)
P0: J7.16, RN1.8 (R1.2), U2.30 (P0)
P1: J7.15, RN1.7 (R2.2), U2.31 (P1)
P2: J7.18, RN1.6 (R3.2), U2.2
P3: J7.17, RN1.5 (R4.2), U2.3
P4: J7.20, RN2.8 (R1.2), U2.4
P5: J7.19, RN2.7 (R2.2), U2.7 (P5)
P6: J7.22, RN2.6 (R3.2), U2.8 (P6)
P7: J7.21, RN2.5 (R4.2), U2.9 (P7)
PVDD: C7.2, C8.2, C12.1, C15.1, C26.2, C27.2, JP9.1 (A), JP16.1 (A), U1.16 (PVDD), U2.17 (P_{VDD})
SCL: J7.11, JP2.1 (A), U1.28 (SCLK), U2.12 (SCL)
SCL-J: JP2.2 (B), U3.7 (GPIO5)
SDA: J7.9, JP1.1 (A), U1.27 (SDATA), U2.11 (SDA)
SDA-J: JP1.2 (B), U3.6 (GPIO4)
SWCLK: U3.41 (SWCLK), U4.4 (GPIO2)
SWDIO: U3.43 (SWDIO), U4.5 (GPIO3)
SoG / B0: JP23.2 (B), S9.1, U3.19 (GPIO14)
Trancoded Pb: J1.3, JP31.1 (A), R64.1
Trancoded Pr: J1.5, JP32.1 (A), R61.1
Trancoded Y: J1.1, JP13.1 (A), R62.1, R63.1
VBAT: C32.1, F2.1, J3.1
VBUS: C31.1, F1.1, J2.A4/B9 (VBUS), J2.B4/A9 (VBUS)
VMUX: C36.1, C37.1, IC2.3 (VIN), IC2.4 (EN), J7.4, JP39.1 (A), JP40.1 (A), JP41.2 (B), R48.1, U5.4 (VIN), U5.5 (EN), U5.6 (MODE)
VS: J4.8, J7.10, JP3.2 (C), JP5.2 (B), R2.2
VS-T: J5.3, R2.1, U1.29 (VS/FIELD/SFL)
Vaseline: S6.1, U3.15 (GPIO11)
YC IN: S2.1, U3.10 (GPIO7)
YPbPr OUT: S3.1, U3.11 (GPIO8)
~7280-Reset: JP11.1 (A), U1.25 (~RESET)
~7391-RESET: JP21.1 (A), U2.14 (~RESET)

Notes on the sheet:
Not sure which rail you want to break out here
Current sense I = V x 0.1
1.8V LDOs
Y / G / CVBS Pb / B / Luma Pr / R / Chroma
PSU Recommended Specs DVDDIO = 3.3v, 20ma DVDD = 1.8v, 110ma AVDD = 1.8v, 100ma PVDD = 1.8v, 20ma .48w Total
Forced-PWM mode for lower ripple
PSU Recommended Specs VDD = 1.8v, 68ma 101max VDD_IO = 3.3v, 1ma 10max AVDD = 1.8v, 100ma PVDD = 1.8v, 20ma .48w Total
Power Inputs
Part operates in forced-PWM mode (low ripple)
2 caps for pin 5 2 caps for pin 28
Expansion Header
Muxed power output (USB or battery) USB has priority
PSU or 1S li-ion input 3V - 5.5V!
169 is a standard value resistor that you can buy. 170 is not
1.89V buck
Datasheet says 170 EVAL board says 169
3.3V buck-boost

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
