Shank-Mods/LumaDoub/hardware/LumaDoubDevBoard/LumaDoubDevBoard.kicad_pcb

## KiCad design hardware/LumaDoubDevBoard/LumaDoubDevBoard.kicad_pcb (continued)

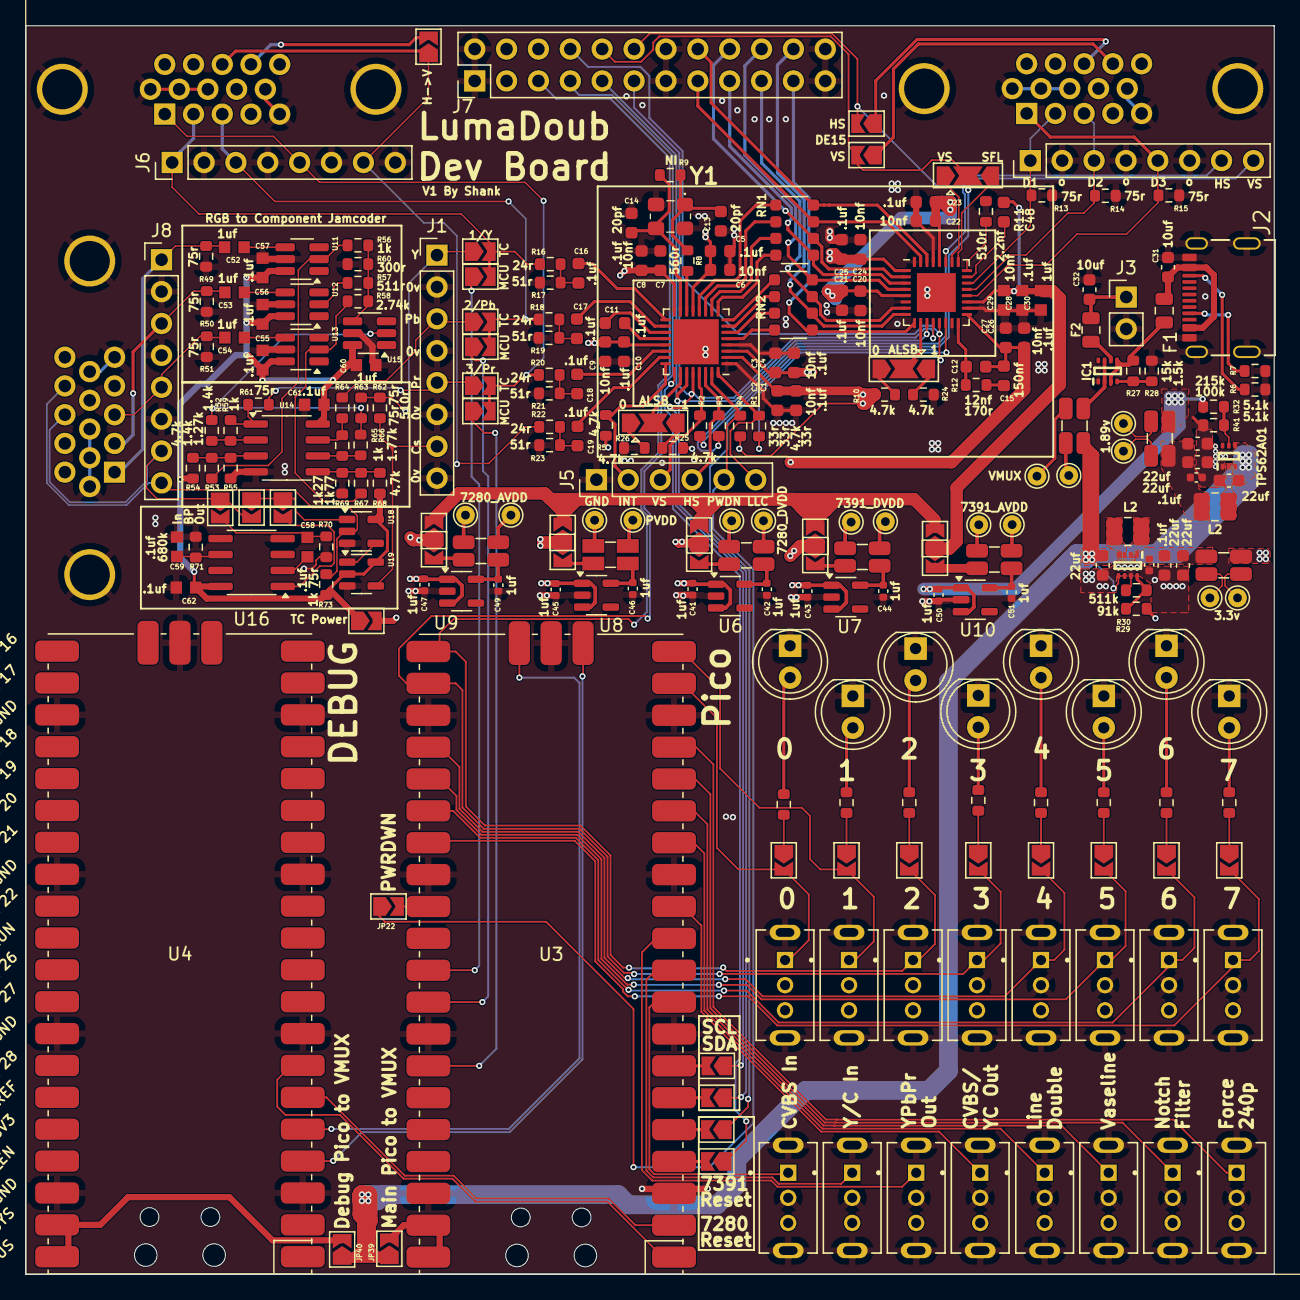
[picture p7: board LumaDoubDevBoard.kicad_pcb from above]

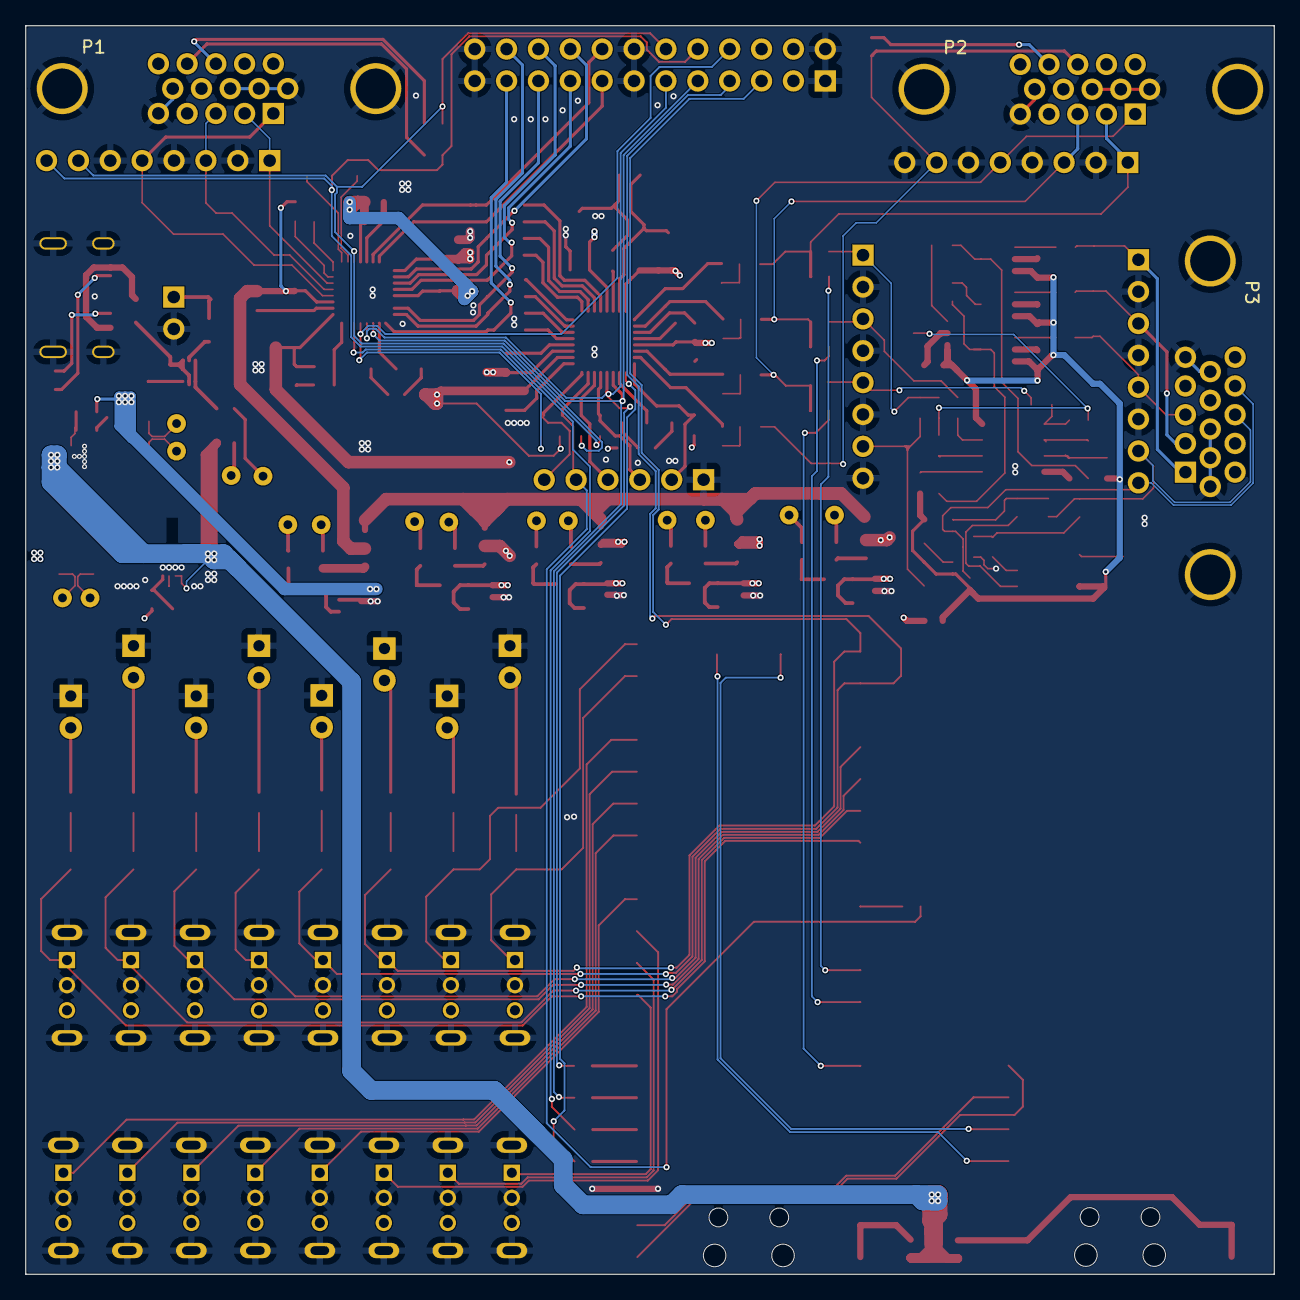
[picture p8: board LumaDoubDevBoard.kicad_pcb from below]

Board: 4 copper layers, 99.5 x 99.5 mm, 253 parts (3 on the bottom side), 190 nets.

Other parts of the board:
P2: VGA_Male; VGA_male_rightangle_slim

Their connections:
GND: P2.5 (HSYNC_GND), P2.6 (Red_GND), P2.7 (Green_GND), P2.8 (Blue_GND), P2.10 (VSYNC_GND), P2.S1 (SHIELD), P2.S2 (SHIELD); also elsewhere on the board
