Shank-Mods/LumaDoub/(commit log)

2024-09-10 Scaffold basic Pi Pico I2C project in firmware directory
2024-09-10 Write first draft of basic I2C logic
    - Define type for I2C commands
    - Create functions to write commands to devices over I2C
    - From provided template scripts (https://www.analog.com/media/en/engineering-tools/design-tools/ADV7280A_Cust.zip), add I2C commands to configure ADV7280A and ADV7391
2024-09-12 Start Kicad dev board
    [LumaDoubDevBoard.kicad_pcb, LumaDoubDevBoard.kicad_sch]
2024-09-12 Saved the schematic
    [LumaDoubDevBoard.kicad_sch]
2024-09-12 Added to the Schematic, Started PCB Layout
    [LumaDoubDevBoard.kicad_sch]
2024-09-12 Add power management to schematic
    [LumaDoubDevBoard.kicad_sch]
2024-09-12 Update 3.3v buck-boost to FPWM mode
    [LumaDoubDevBoard.kicad_sch]
2024-09-12 Add current-sense to VMUX
    [LumaDoubDevBoard.kicad_sch]
2024-09-12 Restore WIP layout file
    [LumaDoubDevBoard.kicad_pcb, LumaDoubDevBoard.kicad_sch]
2024-09-13 Begun core component layout
    [LumaDoubDevBoard.kicad_pcb]
2024-09-13 PCB layout progress
    [LumaDoubDevBoard.kicad_pcb, LumaDoubDevBoard.kicad_sch]
2024-09-14 PCB Work
    [LumaDoubDevBoard.kicad_pcb]
2024-09-14 fix kicad files for 8.99.0.2194
    [LumaDoubDevBoard.kicad_pcb, LumaDoubDevBoard.kicad_sch]
2024-09-14 buck converter routing
    [LumaDoubDevBoard.kicad_pcb, LumaDoubDevBoard.kicad_sch]
2025-02-13 Pull reset lines for both chips low; disable first command in test script; write I2C with a timeout
    This version works.
    [lumadoub-firmware.c]
2025-02-13 Create main polling loop; get some of the switches working in that loop
2025-02-15 Add "vaseline" (antialiasing filter) and line doubling switches
    Note: vaseline filter doesn't seem to be working yet.
    [lumadoub-firmware.c]
2025-02-17 Enable flipping register bits using on-board switches; enable debug output over serial
    [lumadoub-firmware.c]
2025-02-17 Add I2C read capability; force 240p when input signal is interlaced
2025-02-22 Autocycle between inputs; add vaseline and notch filters
    Includes a little bit of main loop tidying.
2026-09-02 Added newer dev board pcb files
    [LumaDoubDevBoard.kicad_pcb, LumaDoubDevBoard.kicad_sch]
2026-09-02 Added newer dev board files
    Maybe to the right location this time?
    [LumaDoubDevBoard.kicad_pcb, LumaDoubDevBoard.kicad_sch]
2026-09-02 Delete LumaDoubDevBoard.kicad_pcb
    oops wrong location
    [LumaDoubDevBoard.kicad_pcb]
2026-09-02 Delete LumaDoubDevBoard.kicad_sch
    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
    [LumaDoubDevBoard.kicad_sch]
2026-09-02 Delete LumaDoubDevBoard.kicad_pro
    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
